adambirtles/libra/block-diagram-bit-serial.png

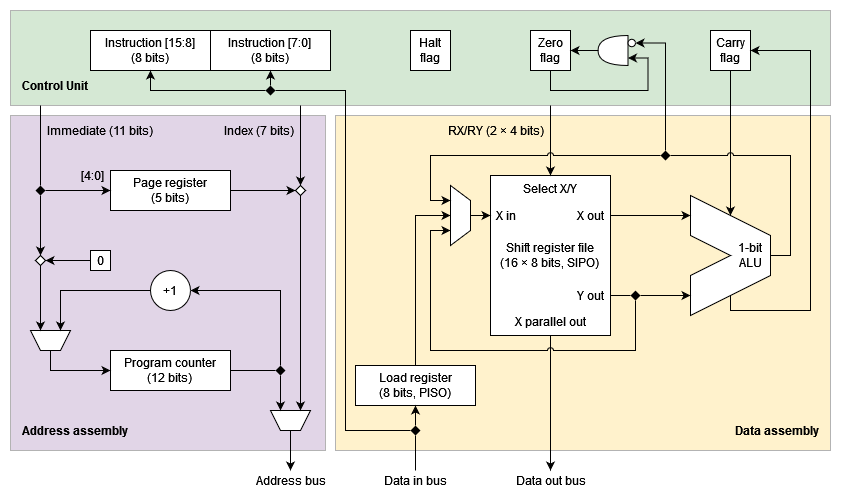
block-diagram-bit-serial.png
