adambirtles/libra/constraints/ports.xdc

set_property IOSTANDARD LVCMOS18 [get_ports {mem_read[7]}]
set_property IOSTANDARD LVCMOS18 [get_ports {mem_read[6]}]
set_property IOSTANDARD LVCMOS18 [get_ports {mem_read[5]}]
set_property IOSTANDARD LVCMOS18 [get_ports {mem_read[4]}]
set_property IOSTANDARD LVCMOS18 [get_ports {mem_read[3]}]
set_property IOSTANDARD LVCMOS18 [get_ports {mem_read[2]}]
set_property IOSTANDARD LVCMOS18 [get_ports {mem_read[1]}]
set_property IOSTANDARD LVCMOS18 [get_ports {mem_read[0]}]
set_property IOSTANDARD LVCMOS18 [get_ports {mem_write[7]}]
set_property IOSTANDARD LVCMOS18 [get_ports {mem_write[6]}]
set_property IOSTANDARD LVCMOS18 [get_ports {mem_write[5]}]
set_property IOSTANDARD LVCMOS18 [get_ports {mem_write[4]}]
set_property IOSTANDARD LVCMOS18 [get_ports {mem_write[3]}]
set_property IOSTANDARD LVCMOS18 [get_ports {mem_write[2]}]
set_property IOSTANDARD LVCMOS18 [get_ports {mem_write[1]}]
set_property IOSTANDARD LVCMOS18 [get_ports {mem_write[0]}]
set_property IOSTANDARD LVCMOS18 [get_ports {mem_addr[11]}]
set_property IOSTANDARD LVCMOS18 [get_ports {mem_addr[10]}]
set_property IOSTANDARD LVCMOS18 [get_ports {mem_addr[9]}]
set_property IOSTANDARD LVCMOS18 [get_ports {mem_addr[8]}]
set_property IOSTANDARD LVCMOS18 [get_ports {mem_addr[7]}]
set_property IOSTANDARD LVCMOS18 [get_ports {mem_addr[6]}]
set_property IOSTANDARD LVCMOS18 [get_ports {mem_addr[5]}]
set_property IOSTANDARD LVCMOS18 [get_ports {mem_addr[4]}]
set_property IOSTANDARD LVCMOS18 [get_ports {mem_addr[3]}]
set_property IOSTANDARD LVCMOS18 [get_ports {mem_addr[2]}]
set_property IOSTANDARD LVCMOS18 [get_ports {mem_addr[1]}]
set_property IOSTANDARD LVCMOS18 [get_ports {mem_addr[0]}]
set_property IOSTANDARD LVCMOS18 [get_ports clock]
set_property IOSTANDARD LVCMOS18 [get_ports errored]
set_property IOSTANDARD LVCMOS18 [get_ports halted]
set_property IOSTANDARD LVCMOS18 [get_ports mem_write_enable]
set_property IOSTANDARD LVCMOS18 [get_ports n_reset]
set_property PACKAGE_PIN M20 [get_ports {mem_read[7]}]
set_property PACKAGE_PIN L20 [get_ports {mem_read[6]}]
set_property PACKAGE_PIN J20 [get_ports {mem_read[5]}]
set_property PACKAGE_PIN H20 [get_ports {mem_read[4]}]
set_property PACKAGE_PIN G20 [get_ports {mem_read[3]}]
set_property PACKAGE_PIN F20 [get_ports {mem_read[2]}]
set_property PACKAGE_PIN D20 [get_ports {mem_read[1]}]
set_property PACKAGE_PIN C20 [get_ports {mem_read[0]}]
set_property PACKAGE_PIN M19 [get_ports {mem_write[7]}]
set_property PACKAGE_PIN L19 [get_ports {mem_write[6]}]
set_property PACKAGE_PIN K19 [get_ports {mem_write[5]}]
set_property PACKAGE_PIN J19 [get_ports {mem_write[4]}]
set_property PACKAGE_PIN G19 [get_ports {mem_write[3]}]
set_property PACKAGE_PIN F19 [get_ports {mem_write[2]}]
set_property PACKAGE_PIN E19 [get_ports {mem_write[1]}]
set_property PACKAGE_PIN D19 [get_ports {mem_write[0]}]
set_property PACKAGE_PIN M18 [get_ports {mem_addr[11]}]
set_property PACKAGE_PIN K18 [get_ports {mem_addr[10]}]
set_property PACKAGE_PIN J18 [get_ports {mem_addr[9]}]
set_property PACKAGE_PIN H18 [get_ports {mem_addr[8]}]
set_property PACKAGE_PIN G18 [get_ports {mem_addr[7]}]
set_property PACKAGE_PIN E18 [get_ports {mem_addr[6]}]
set_property PACKAGE_PIN M17 [get_ports {mem_addr[5]}]
set_property PACKAGE_PIN L17 [get_ports {mem_addr[4]}]
set_property PACKAGE_PIN K17 [get_ports {mem_addr[3]}]
set_property PACKAGE_PIN H17 [get_ports {mem_addr[2]}]
set_property PACKAGE_PIN G17 [get_ports {mem_addr[1]}]
set_property PACKAGE_PIN E17 [get_ports {mem_addr[0]}]
set_property PACKAGE_PIN F16 [get_ports n_reset]
set_property PACKAGE_PIN H16 [get_ports clock]
set_property PACKAGE_PIN J16 [get_ports errored]
set_property PACKAGE_PIN K16 [get_ports halted]
set_property PACKAGE_PIN L16 [get_ports mem_write_enable]
