adambirtles/libra/src/cpu.vhd

library ieee;
use ieee.std_logic_1164.all;
use ieee.numeric_std.all;

use work.opcodes.all;

entity cpu is
    generic(bit_serial: boolean);
    port(
        clock: in std_ulogic;
        n_reset: in std_ulogic;

        mem_read: in std_ulogic_vector(7 downto 0);
        mem_write: out std_ulogic_vector(7 downto 0);
        mem_addr: out unsigned(11 downto 0);
        mem_write_enable: out std_ulogic;

        halted: out std_ulogic;
        errored: out std_ulogic
    );
end entity;

architecture rtl of cpu is
    signal control_clock: std_ulogic;
    signal action_clock: std_ulogic;

    signal halt: std_ulogic;
    signal carry: std_ulogic;
    signal zero: std_ulogic;

    signal c_in: std_ulogic;
    signal z_in: std_ulogic;

    signal opcode: cpu_opcode;
    signal operand_rx: std_ulogic_vector(3 downto 0);
    signal operand_ry: std_ulogic_vector(3 downto 0);
    signal operand_index: std_ulogic_vector(6 downto 0);
    signal operand_immediate: std_ulogic_vector(10 downto 0);

    signal alu_carry: std_ulogic;

    signal pc_in: unsigned(11 downto 0);
    signal pc_out: unsigned(11 downto 0);
    signal pc_increment: unsigned(11 downto 0);
    signal indexed_addr: unsigned(11 downto 0);

    signal ir_out: std_ulogic_vector(15 downto 0);
    signal pg_out: std_ulogic_vector(4 downto 0);

    signal selected_test: std_ulogic;
    signal test: std_ulogic;

    -- Control lines
    signal pc_write_enable: std_ulogic;
    signal pg_write_enable: std_ulogic;
    signal irh_write_enable: std_ulogic;
    signal irl_write_enable: std_ulogic;
    signal c_write_enable: std_ulogic;
    signal z_write_enable: std_ulogic;

    -- Selectors
    type addr_selector is (ADDR_SELECT_PC, ADDR_SELECT_INDEXED);
    signal addr_select: addr_selector;

    type pc_in_selector is (PC_IN_SELECT_INCREMENT, PC_IN_SELECT_OPERAND);
    signal pc_in_select: pc_in_selector;

    type c_in_selector is (C_IN_SELECT_CLEAR, C_IN_SELECT_ALU);
    signal c_in_select: c_in_selector;

    constant TEST_SELECT_ZERO: std_ulogic := '0';
    constant TEST_SELECT_CARRY: std_ulogic := '1';
begin
    -- Clocking
    divide_clock: process(clock, n_reset) is
    begin
        if n_reset = '0' then
            control_clock <= '1';
            action_clock <= '0';
        elsif rising_edge(clock) then
            control_clock <= not control_clock;
            action_clock <= not action_clock;
        end if;
    end process;

    -- IR is implemented as two 8-bit registers
    reg_irh: entity work.parallel_register(rtl)
        generic map(data_width => 8)
        port map(
            clock => action_clock,
            n_reset => n_reset,
            write_enable => irh_write_enable,
            data_in => mem_read,
            data_out => ir_out(15 downto 8)
        );
    reg_irl: entity work.parallel_register(rtl)
        generic map(data_width => 8)
        port map(
            clock => action_clock,
            n_reset => n_reset,
            write_enable => irl_write_enable,
            data_in => mem_read,
            data_out => ir_out(7 downto 0)
        );

    reg_pg: entity work.parallel_register(rtl)
        generic map(data_width => 5)
        port map(
            clock => action_clock,
            n_reset => n_reset,
            write_enable => pg_write_enable,
            data_in => operand_immediate(4 downto 0),
            data_out => pg_out
        );

    reg_pc: entity work.parallel_register(rtl)
        generic map(data_width => 12)
        port map(
            clock => action_clock,
            n_reset => n_reset,
            write_enable => pc_write_enable,
            data_in => std_ulogic_vector(pc_in),
            unsigned(data_out) => pc_out
        );

    pc_inc: entity work.incrementer(struct)
        generic map(data_width => 12)
        port map(
            data_in => pc_out,
            data_out => pc_increment
        );

    carry_flag: entity work.flag(rtl)
        port map(
            clock => action_clock,
            n_reset => n_reset,
            write_enable => c_write_enable,
            data_in => c_in,
            data_out => carry
        );
    zero_flag: entity work.flag(rtl)
        port map(
            clock => action_clock,
            n_reset => n_reset,
            write_enable => z_write_enable,
            data_in => z_in,
            data_out => zero
        );

    mux_addr: with addr_select
    select mem_addr <=
        pc_out                           when ADDR_SELECT_PC,
        unsigned(pg_out & operand_index) when ADDR_SELECT_INDEXED;

    mux_pc_in: with pc_in_select
    select pc_in <=
        pc_increment                      when PC_IN_SELECT_INCREMENT,
        unsigned(operand_immediate & '0') when PC_IN_SELECT_OPERAND;

    mux_c_in: with c_in_select
    select c_in <=
        '0'           when C_IN_SELECT_CLEAR,
        alu_carry     when C_IN_SELECT_ALU;

    mux_test: with opcode(0)
    select selected_test <=
        zero  when TEST_SELECT_ZERO,
        carry when TEST_SELECT_CARRY,
        'X'   when others;

    test <= selected_test xor opcode(1);

    opcode <= ir_out(15 downto 11);
    operand_rx <= ir_out(10 downto 7);
    operand_ry <= ir_out(6 downto 3);
    operand_index <= ir_out(6 downto 0);
    operand_immediate <= ir_out(10 downto 0);

    gen_bit_serial: if bit_serial generate
        signal ld_out: std_ulogic;
        signal rx_in: std_ulogic;
        signal alu_result: std_ulogic;

        signal rx_out: std_ulogic_vector(7 downto 0);
        signal ry_out: std_ulogic_vector(7 downto 0);

        signal ld_write_enable: std_ulogic;
        signal ld_shift_enable: std_ulogic;
        signal regfile_shift_enable: std_ulogic;

        type rx_in_selector is (
            RX_IN_SELECT_LOAD,
            RX_IN_SELECT_RY,
            RX_IN_SELECT_ALU
        );
        signal rx_in_select: rx_in_selector;

        type z_in_selector is (Z_IN_SELECT_SET, Z_IN_SELECT_RESULT);
        signal z_in_select: z_in_selector;

        type cpu_state is (
            -- Fetch
            FETCH_HIGH,
            FETCH_HIGH_INC_PC,
            FETCH_LOW,
            FETCH_LOW_INC_PC,

            -- Decode
            DECODE,

            -- Execute
            EXECUTE_NOP,
            EXECUTE_HALT,
            EXECUTE_COPY,
            EXECUTE_LOAD_FETCH,
            EXECUTE_LOAD_SHIFT_IN,
            EXECUTE_STORE,
            EXECUTE_SET_PAGE,
            EXECUTE_JUMP,
            EXECUTE_TEST,
            EXECUTE_CLEAR_CARRY,
            EXECUTE_SET_ZERO,
            EXECUTE_ALU_OP,
            EXECUTE_END,

            -- Error
            ERROR
        );
        signal state: cpu_state;

        subtype steps is integer range 0 to 7;
        signal step_count: steps;
    begin
        reg_ld: entity work.piso_register(rtl)
            generic map(data_width => 8)
            port map(
                clock => action_clock,
                n_reset => n_reset,
                write_enable => ld_write_enable,
                shift_enable => ld_shift_enable,
                shift_in => '0',
                data_in => mem_read,
                data_out => ld_out
            );

        regfile: entity work.shift_register_file(rtl)
            generic map(data_width => 8)
            port map(
                clock => action_clock,
                n_reset => n_reset,
                shift_enable => regfile_shift_enable,
                x_select => operand_rx,
                x_in => rx_in,
                std_ulogic_vector(x_out) => rx_out,
                y_select => operand_ry,
                std_ulogic_vector(y_out) => ry_out
            );

        alu: entity work.alu(struct)
            generic map(data_width => 1)
            port map(
                opcode => opcode(2 downto 0),
                lhs(0) => rx_out(0),
                rhs(0) => ry_out(0),
                carry_in => carry,
                result(0) => alu_result,
                carry_out => alu_carry
            );

        mux_rx_in: with rx_in_select
        select rx_in <=
            ld_out     when RX_IN_SELECT_LOAD,
            ry_out(0)  when RX_IN_SELECT_RY,
            alu_result when RX_IN_SELECT_ALU;

        mux_z_in: with z_in_select
        select z_in <=
            '1'                     when Z_IN_SELECT_SET,
            zero and not alu_result when Z_IN_SELECT_RESULT;

        mem_write <= rx_out;

        process(control_clock, n_reset) is
            procedure init_step(constant value: steps := 7) is
            begin
                step_count <= value;
            end procedure;

            procedure next_step is
            begin
                if step_count = 0 then
                    state <= EXECUTE_END;
                else
                    step_count <= step_count - 1;
                end if;
            end procedure;
        begin
            mem_write_enable <= '0';
            pc_write_enable <= '0';
            pg_write_enable <= '0';
            irh_write_enable <= '0';
            irl_write_enable <= '0';
            c_write_enable <= '0';
            z_write_enable <= '0';
            addr_select <= ADDR_SELECT_PC;
            pc_in_select <= PC_IN_SELECT_INCREMENT;

            ld_write_enable <= '0';
            ld_shift_enable <= '0';
            regfile_shift_enable <= '0';
            rx_in_select <= RX_IN_SELECT_LOAD;
            c_in_select <= C_IN_SELECT_CLEAR;
            z_in_select <= Z_IN_SELECT_SET;

            if n_reset = '0' then
                state <= FETCH_HIGH;
                halt <= '0';
                halted <= '0';
                errored <= '0';
            elsif rising_edge(control_clock) then
                case state is
                    when FETCH_HIGH =>
                        irh_write_enable <= '1';
                        addr_select <= ADDR_SELECT_PC;
                        state <= FETCH_HIGH_INC_PC;

                    when FETCH_HIGH_INC_PC =>
                        pc_write_enable <= '1';
                        pc_in_select <= PC_IN_SELECT_INCREMENT;
                        state <= FETCH_LOW;

                    when FETCH_LOW =>
                        irl_write_enable <= '1';
                        addr_select <= ADDR_SELECT_PC;
                        state <= FETCH_LOW_INC_PC;

                    when FETCH_LOW_INC_PC =>
                        pc_write_enable <= '1';
                        pc_in_select <= PC_IN_SELECT_INCREMENT;
                        state <= DECODE;

                    when DECODE =>
                        case opcode is
                            when OP_NOP =>
                                state <= EXECUTE_NOP;
                            when OP_HALT =>
                                state <= EXECUTE_HALT;
                            when OP_COPY =>
                                init_step;
                                state <= EXECUTE_COPY;
                            when OP_LOAD =>
                                state <= EXECUTE_LOAD_FETCH;
                            when OP_STORE =>
                                state <= EXECUTE_STORE;
                            when OP_SET_PAGE =>
                                state <= EXECUTE_SET_PAGE;
                            when OP_JUMP =>
                                state <= EXECUTE_JUMP;
                            when OP_JUMP_Z | OP_JUMP_C | OP_JUMP_NZ | OP_JUMP_NC =>
                                state <= EXECUTE_TEST;
                            when OP_ADD | OP_LSHIFT | OP_RSHIFT =>
                                state <= EXECUTE_CLEAR_CARRY;
                            when OP_AND | OP_OR | OP_XOR | OP_NOT | OP_ADD_C | OP_LSHIFT_C | OP_RSHIFT_C =>
                                state <= EXECUTE_SET_ZERO;
                            when others =>
                                state <= ERROR;
                        end case;

                    when EXECUTE_NOP =>
                        -- This case is intentionally left blank
                        state <= EXECUTE_END;

                    when EXECUTE_HALT =>
                        halt <= '1';
                        state <= EXECUTE_END;

                    when EXECUTE_COPY =>
                        rx_in_select <= RX_IN_SELECT_RY;
                        regfile_shift_enable <= '1';
                        next_step;

                    when EXECUTE_LOAD_FETCH =>
                        addr_select <= ADDR_SELECT_INDEXED;
                        ld_write_enable <= '1';
                        init_step;
                        state <= EXECUTE_LOAD_SHIFT_IN;

                    when EXECUTE_LOAD_SHIFT_IN =>
                        rx_in_select <= RX_IN_SELECT_LOAD;
                        ld_shift_enable <= '1';
                        regfile_shift_enable <= '1';
                        next_step;

                    when EXECUTE_STORE =>
                        mem_write_enable <= '1';
                        addr_select <= ADDR_SELECT_INDEXED;
                        state <= EXECUTE_END;

                    when EXECUTE_SET_PAGE =>
                        pg_write_enable <= '1';
                        state <= EXECUTE_END;

                    when EXECUTE_JUMP =>
                        pc_write_enable <= '1';
                        pc_in_select <= PC_IN_SELECT_OPERAND;
                        state <= EXECUTE_END;

                    when EXECUTE_TEST =>
                        if test = '1' then
                            state <= EXECUTE_JUMP;
                        else
                            state <= EXECUTE_END;
                        end if;

                    when EXECUTE_CLEAR_CARRY =>
                        c_write_enable <= '1';
                        c_in_select <= C_IN_SELECT_CLEAR;
                        state <= EXECUTE_SET_ZERO;

                    when EXECUTE_SET_ZERO =>
                        z_write_enable <= '1';
                        z_in_select <= Z_IN_SELECT_SET;
                        case opcode is
                            when OP_RSHIFT | OP_RSHIFT_C =>
                                init_step(0);
                            when others =>
                                init_step;
                        end case;
                        state <= EXECUTE_ALU_OP;

                    when EXECUTE_ALU_OP =>
                        c_write_enable <= '1';
                        z_write_enable <= '1';
                        rx_in_select <= RX_IN_SELECT_ALU;
                        c_in_select <= C_IN_SELECT_ALU;
                        regfile_shift_enable <= '1';
                        z_in_select <= Z_IN_SELECT_RESULT;
                        next_step;

                    when EXECUTE_END =>
                        if halt = '0' then
                            state <= FETCH_HIGH;
                        else
                            halted <= halt;
                        end if;

                    when ERROR =>
                        -- oh no!
                        errored <= '1';
                end case;
            end if;
        end process;
    end generate;

    gen_classical: if not bit_serial generate
        signal rx_in: std_ulogic_vector(7 downto 0);
        signal rx_out: std_ulogic_vector(7 downto 0);
        signal ry_out: std_ulogic_vector(7 downto 0);
        signal alu_result: std_ulogic_vector(7 downto 0);

        signal rx_write_enable: std_ulogic;

        type rx_in_selector is (RX_IN_SELECT_LOAD, RX_IN_SELECT_RY, RX_IN_SELECT_ALU);
        signal rx_in_select: rx_in_selector;

        type cpu_state is (
            -- Fetch
            FETCH_HIGH,
            FETCH_HIGH_INC_PC,
            FETCH_LOW,
            FETCH_LOW_INC_PC,

            -- Decode
            DECODE,

            -- Execute
            EXECUTE_NOP,
            EXECUTE_HALT,
            EXECUTE_COPY,
            EXECUTE_LOAD,
            EXECUTE_STORE,
            EXECUTE_SET_PAGE,
            EXECUTE_JUMP,
            EXECUTE_TEST,
            EXECUTE_CLEAR_CARRY,
            EXECUTE_ALU_OP,
            EXECUTE_END,

            -- Error
            ERROR
        );
        signal state: cpu_state;
    begin
        regfile: entity work.parallel_register_file(rtl)
            generic map(data_width => 8)
            port map(
                clock => action_clock,
                n_reset => n_reset,
                x_select => operand_rx,
                x_write_enable => rx_write_enable,
                x_in => rx_in,
                std_ulogic_vector(x_out) => rx_out,
                y_select => operand_ry,
                std_ulogic_vector(y_out) => ry_out
            );

        alu: entity work.alu(struct)
            generic map(data_width => 8)
            port map(
                opcode => opcode(2 downto 0),
                lhs => rx_out,
                rhs => ry_out,
                carry_in => carry,
                result => alu_result,
                carry_out => alu_carry
            );

        mux_rx_in: with rx_in_select
        select rx_in <=
            mem_read        when RX_IN_SELECT_LOAD,
            ry_out          when RX_IN_SELECT_RY,
            alu_result      when RX_IN_SELECT_ALU;

        z_in <= '1' when alu_result = "00000000" else '0';

        mem_write <= rx_out;

        process(control_clock, n_reset)
        begin
            mem_write_enable <= '0';
            pc_write_enable <= '0';
            pg_write_enable <= '0';
            irh_write_enable <= '0';
            irl_write_enable <= '0';
            c_write_enable <= '0';
            z_write_enable <= '0';
            addr_select <= ADDR_SELECT_PC;
            pc_in_select <= PC_IN_SELECT_INCREMENT;

            rx_write_enable <= '0';
            rx_in_select <= RX_IN_SELECT_LOAD;
            c_in_select <= C_IN_SELECT_CLEAR;

            if n_reset = '0' then
                state <= FETCH_HIGH;
                halt <= '0';
                halted <= '0';
                errored <= '0';
            elsif rising_edge(control_clock) then
                case state is
                    when FETCH_HIGH =>
                        irh_write_enable <= '1';
                        addr_select <= ADDR_SELECT_PC;
                        state <= FETCH_HIGH_INC_PC;

                    when FETCH_HIGH_INC_PC =>
                        pc_write_enable <= '1';
                        pc_in_select <= PC_IN_SELECT_INCREMENT;
                        state <= FETCH_LOW;

                    when FETCH_LOW =>
                        irl_write_enable <= '1';
                        addr_select <= ADDR_SELECT_PC;
                        state <= FETCH_LOW_INC_PC;

                    when FETCH_LOW_INC_PC =>
                        pc_write_enable <= '1';
                        pc_in_select <= PC_IN_SELECT_INCREMENT;
                        state <= DECODE;

                    when DECODE =>
                        case opcode is
                            when OP_NOP =>
                                state <= EXECUTE_NOP;
                            when OP_HALT =>
                                state <= EXECUTE_HALT;
                            when OP_COPY =>
                                state <= EXECUTE_COPY;
                            when OP_LOAD =>
                                state <= EXECUTE_LOAD;
                            when OP_STORE =>
                                state <= EXECUTE_STORE;
                            when OP_SET_PAGE =>
                                state <= EXECUTE_SET_PAGE;
                            when OP_JUMP =>
                                state <= EXECUTE_JUMP;
                            when OP_JUMP_Z | OP_JUMP_C | OP_JUMP_NZ | OP_JUMP_NC =>
                                state <= EXECUTE_TEST;
                            when OP_ADD | OP_LSHIFT | OP_RSHIFT =>
                                state <= EXECUTE_CLEAR_CARRY;
                            when OP_AND | OP_OR | OP_XOR | OP_NOT | OP_ADD_C | OP_LSHIFT_C | OP_RSHIFT_C =>
                                state <= EXECUTE_ALU_OP;
                            when others =>
                                state <= ERROR;
                        end case;

                    when EXECUTE_NOP =>
                        -- This case is intentionally left blank
                        state <= EXECUTE_END;

                    when EXECUTE_HALT =>
                        halt <= '1';
                        state <= EXECUTE_END;

                    when EXECUTE_COPY =>
                        rx_in_select <= RX_IN_SELECT_RY;
                        rx_write_enable <= '1';
                        state <= EXECUTE_END;

                    when EXECUTE_LOAD =>
                        addr_select <= ADDR_SELECT_INDEXED;
                        rx_in_select <= RX_IN_SELECT_LOAD;
                        rx_write_enable <= '1';
                        state <= EXECUTE_END;

                    when EXECUTE_STORE =>
                        mem_write_enable <= '1';
                        addr_select <= ADDR_SELECT_INDEXED;
                        state <= EXECUTE_END;

                    when EXECUTE_SET_PAGE =>
                        pg_write_enable <= '1';
                        state <= EXECUTE_END;

                    when EXECUTE_JUMP =>
                        pc_write_enable <= '1';
                        pc_in_select <= PC_IN_SELECT_OPERAND;
                        state <= EXECUTE_END;

                    when EXECUTE_TEST =>
                        if test = '1' then
                            state <= EXECUTE_JUMP;
                        else
                            state <= EXECUTE_END;
                        end if;

                    when EXECUTE_CLEAR_CARRY =>
                        c_write_enable <= '1';
                        c_in_select <= C_IN_SELECT_CLEAR;
                        state <= EXECUTE_ALU_OP;

                    when EXECUTE_ALU_OP =>
                        c_write_enable <= '1';
                        z_write_enable <= '1';
                        rx_in_select <= RX_IN_SELECT_ALU;
                        c_in_select <= C_IN_SELECT_ALU;
                        rx_write_enable <= '1';
                        state <= EXECUTE_END;

                    when EXECUTE_END =>
                        if halt = '0' then
                            state <= FETCH_HIGH;
                        else
                            halted <= halt;
                        end if;

                    when ERROR =>
                        -- oh no!
                        errored <= '1';
                end case;
            end if;
        end process;
    end generate;
end architecture;
