adambirtles/libra/src/components/piso_register.vhd

library ieee;
use ieee.std_logic_1164.all;

-- Parallel in, serial out (SIPO) shift register
-- Shifts downwards/rightwards on the rising edge of `clock` when `shift_enable`
-- is high. The value shifted into the MSB is decided by `shift_in`.
entity piso_register is
    generic(data_width: integer);
    port (
        clock: in std_ulogic;
        n_reset: in std_ulogic;

        write_enable: in std_ulogic;
        shift_enable: in std_ulogic;
        shift_in: in std_ulogic;
        data_in: in std_ulogic_vector((data_width - 1) downto 0);
        data_out: out std_ulogic
    );
end entity;

architecture rtl of piso_register is
    signal data: std_ulogic_vector((data_width - 1) downto 0);
begin
    data_out <= data(0);

    process(clock, n_reset)
    begin
        if n_reset = '0' then
            data <= (others => '0');
        elsif rising_edge(clock) then
            if write_enable = '1' then
                data <= data_in;
            elsif shift_enable = '1' then
                data((data_width - 2) downto 0) <= data((data_width - 1) downto 1);
                data(data_width - 1) <= shift_in;
            end if;
        end if;
    end process;
end architecture;
