adambirtles/libra/(commit log)

2021-10-05 Get started on control logic
    Also:
    - Add simple testbench
    - Fix multiple driver errors in registers
    [cpu_parallel.vhd, parallel_register.vhd, piso_register.vhd, sipo_register.vhd]
2021-11-01 Make memory in fib testbench actually writable
    Also fixed:
    - Store instruction in program used wrong register
    - Final assert checked the wrong memory location
    [fibonacci.vhd]
2021-11-02 Remove increment
    It doesn't work for the bit-serial implementation and I don't have time
    to fix it.
    [alu.vhd, fibonacci.vhd]
2022-04-28 Update terminology in specification
    Also fixes a couple errors left from the removal of increment.
2022-04-28 Mostly fix bit-serial shift implementation
    [cpu.vhd, opcodes.vhd]
2022-04-30 Add insertion sort test program
2022-05-01 Fix small initialisation errors
    [multiplication.vhd, test_harness.vhd]
2022-05-03 Improve fix for shifting issue
    Left-shift now runs perfectly and the bit-serial implementation can run
    much faster.
    [cpu.vhd, testing.vhd]
